erlndb160504/SMART-WATER-METER/Documentation/Dashboard.jpg

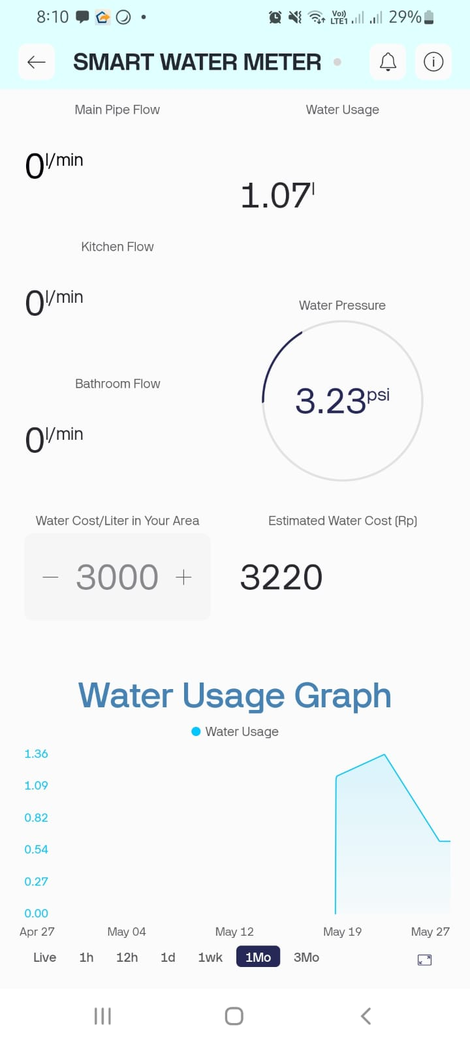
Documentation/Dashboard.jpg
