erlndb160504/SMART-WATER-METER/Documentation/Notification Log.jpg

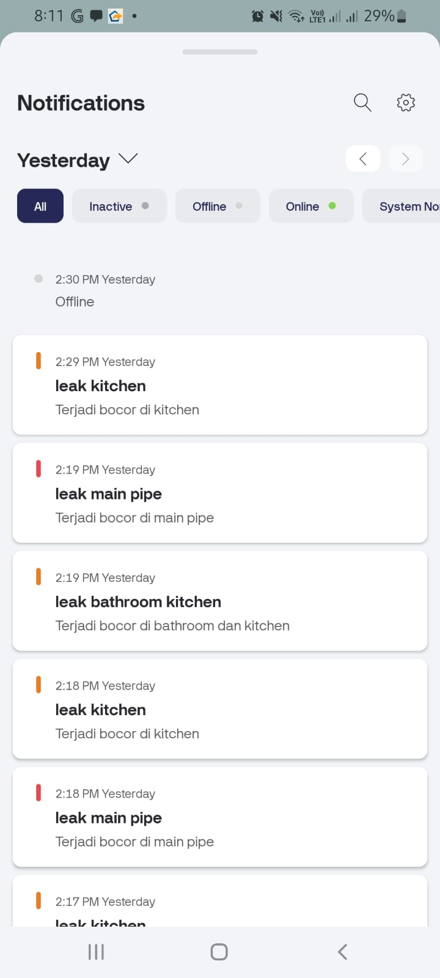
Documentation/Notification Log.jpg
